ymkn/GamingSquare/README.md

# GamingSquare

A customizable left-hand mechanical keyboard for gaming.

## LICENSE

This project is licensed under the MIT License, see the [LICENSE file](LICENSE) for details.
