ymkn/GamingSquare/KiCAD/GamingSquare_Plate/production/GamingSquare_Plate_1.0/bom.csv

Designator | Footprint | Quantity | Value | LCSC Part #
SW1, SW10, SW11, SW12, SW13, SW14, SW15, SW16, SW17, SW18, SW19, SW2, SW20, SW21, SW22, SW23, SW24, SW25, SW26, SW27, SW28, SW29, SW3, SW31, SW4, SW5, SW6, SW7, SW8, SW9 | SW_Hole_1u | 30 | SW_Push
SW30 | SW_Hole_1.75u | 1 | SW_Push
SWe | SW_Hole_2.75u | 1 | SW_Push
