ymkn/GamingSquare/KiCAD/GamingSquare_PCB/production/GamingSquare_PCB_1.0/bom.csv

Designator | Footprint | Quantity | Value | LCSC Part #
D1, D10, D11, D12, D13, D14, D15, D16, D17, D18, D19, D2, D20, D21, D22, D23, D24, D25, D26, D27, D28, D29, D3, D30, D31, D32, D4, D5, D6, D7, D8, D9 | D_SOD-123 | 32 | 1N4148W
SW1, SW10, SW11, SW12, SW13, SW14, SW15, SW16, SW17, SW18, SW19, SW2, SW20, SW21, SW22, SW23, SW24, SW25, SW26, SW27, SW28, SW29, SW3, SW31, SW4, SW5, SW6, SW7, SW8, SW9 | SW_Hotswap_Kailh_MX_1.00u | 30 | SW_Push
SW30 | SW_Hotswap_Kailh_MX_1.75u | 1 | SW_Push
SW32 | SW_Hotswap_Kailh_MX_2.75u | 1 | SW_Push
U1 | rp2040-zero-tht | 1 | rp2040-zero
