ymkn/GamingSquare/FreeCAD/GamingSquare-Case.step

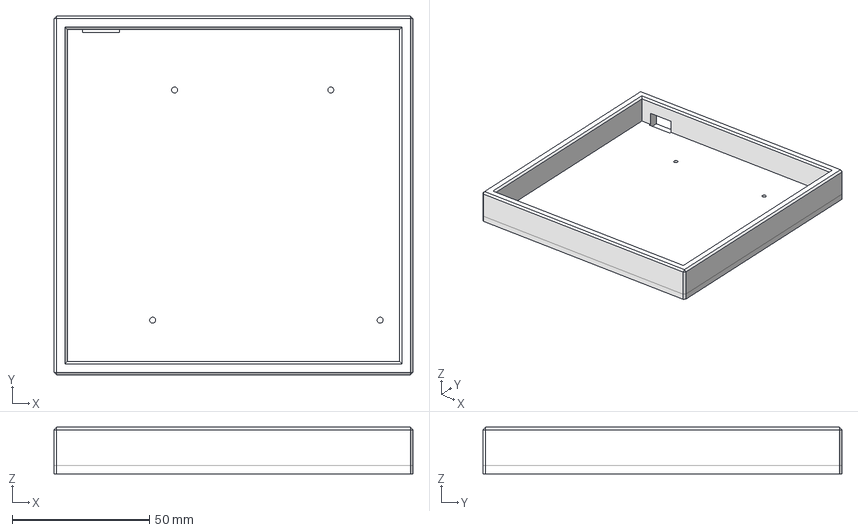
[picture p1: CAD file, 2023-11-23]
FreeCAD/GamingSquare-Case.step
131.0 x 131.0 x 17.0 mm
