ymkn/GamingSquare/(list of files, cad)

Other CAD files:
FreeCAD/GamingSquare.FCStd
FreeCAD/GamingSquare-Case.stl
