ymkn/GamingSquare/(commit log)

2023-12-04 PRK Firmware追加
2023-12-06 ライセンスファイルの追加
2023-12-10 QMK Firmwareの追加
2024-05-02 ビルドガイドの追加
    [GamingSquare-Case.step, GamingSquare-Case.stl]
2024-05-02 ケースデータの表記修正
